fran-byte/ESP32-S3-Mini-I-O-Contoller/img/pcb.jpg

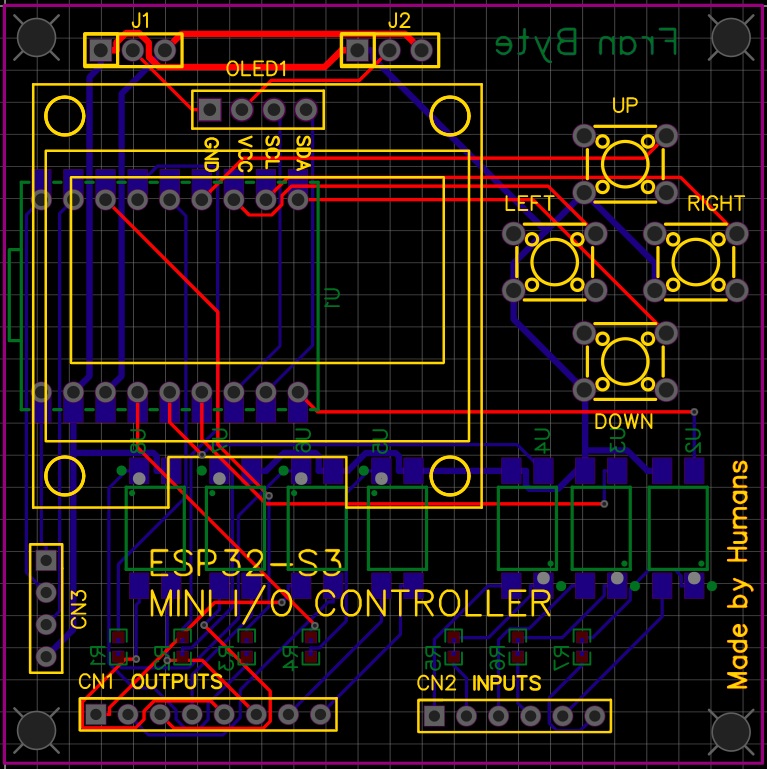
img/pcb.jpg
