fran-byte/ESP32-S3-Mini-I-O-Contoller/Schematic_Esp32-Oled_2026-02-13.png

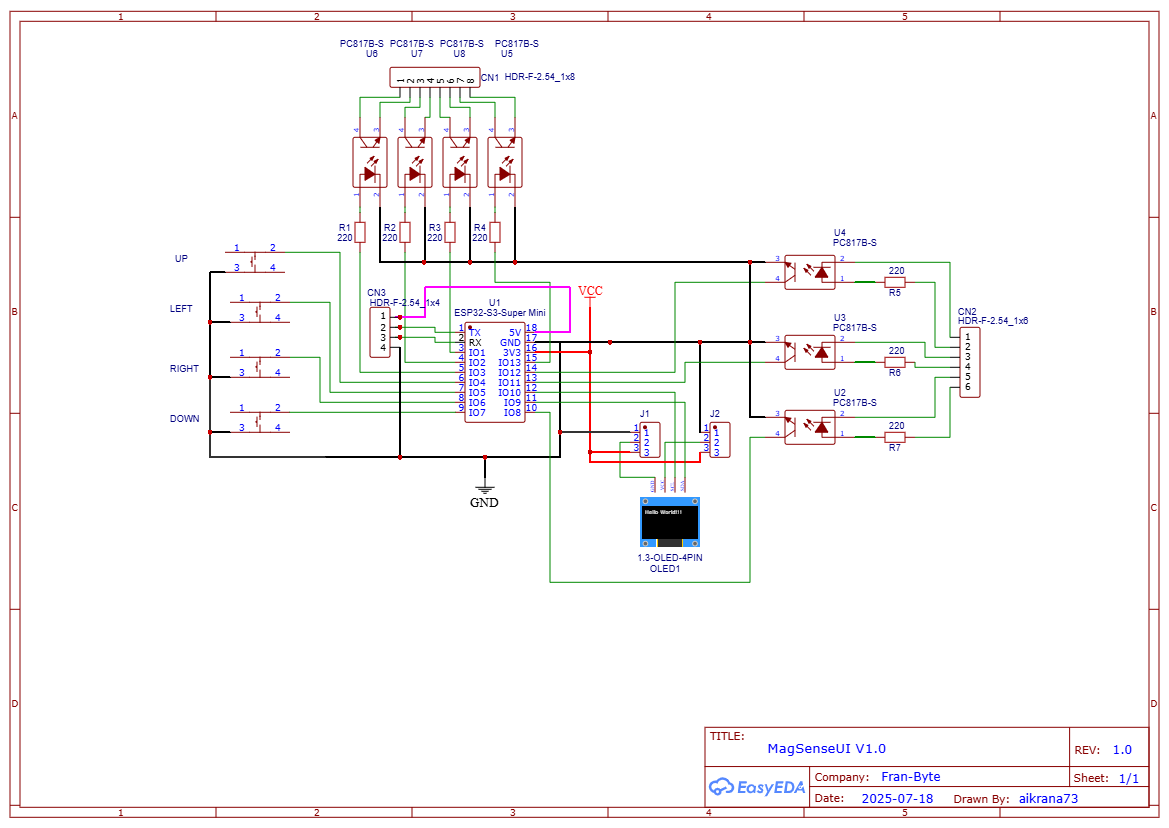
Schematic_Esp32-Oled_2026-02-13.png
