fran-byte/ESP32-S3-Mini-I-O-Contoller/(commit log)

2026-02-13 Enhance button handling with improved comments
2026-02-13 Add speed control and telemetry features to Motor
2026-02-13 Refactor MotorProfile and ProfileStore for clarity
2026-02-13 Revise README for ESP32-S3-MiniController v1.0
    Updated README to reflect new features and details for the ESP32-S3-MiniController.
2026-02-13 Change exit button from SELECT to LEFT in diagnostics
    Updated exit button instruction from SELECT to LEFT in diagnostics.
