fran-byte/ESP32-S3-Mini-I-O-Contoller/(notices)

Notices in the files:
README.md:
📜 License:
[License: MIT](/LICENSE.txt)
